Fugate-A/InterfaceWebAppSeniorDesign/Schematics/3D Files/AutoDesk/ChairBasePrototypePNG.png

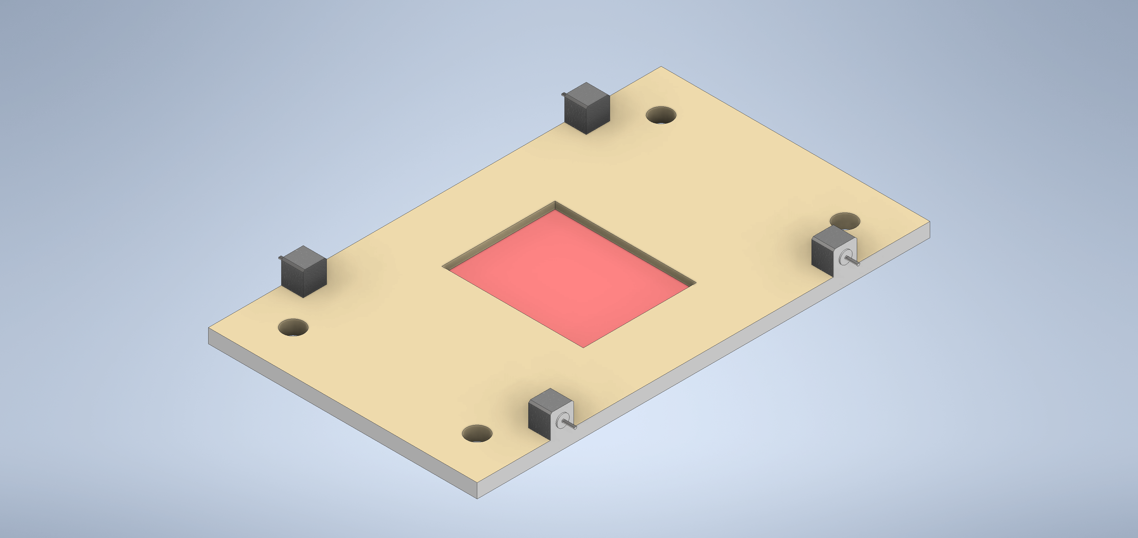
Schematics/3D Files/AutoDesk/ChairBasePrototypePNG.png
