Fugate-A/InterfaceWebAppSeniorDesign/WebAppPics/ChairGuruOverviewCommandSent.png

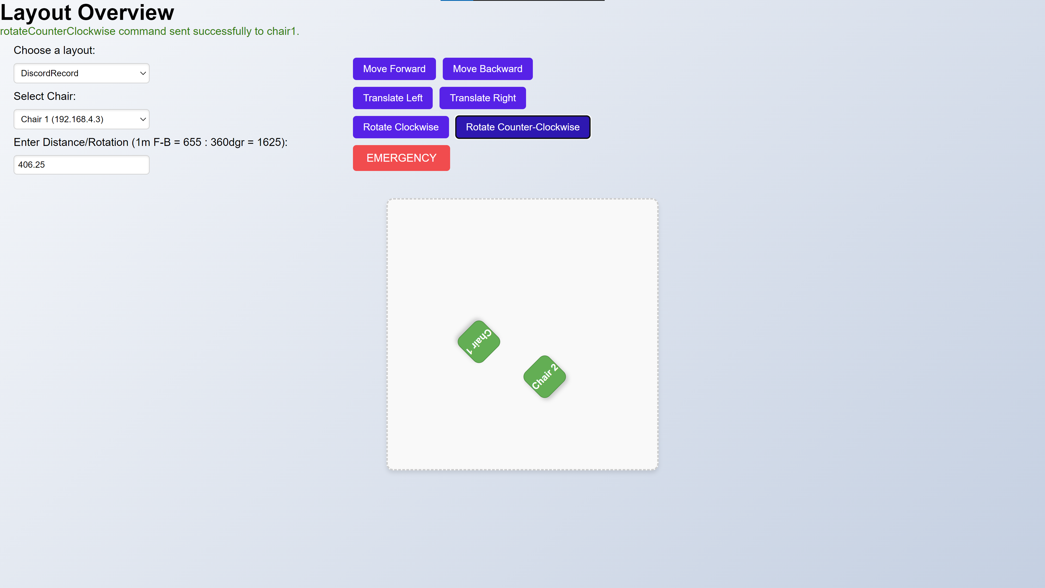
WebAppPics/ChairGuruOverviewCommandSent.png
