Fugate-A/InterfaceWebAppSeniorDesign/SoftwareDiagrams/ClassDiagramSD.png

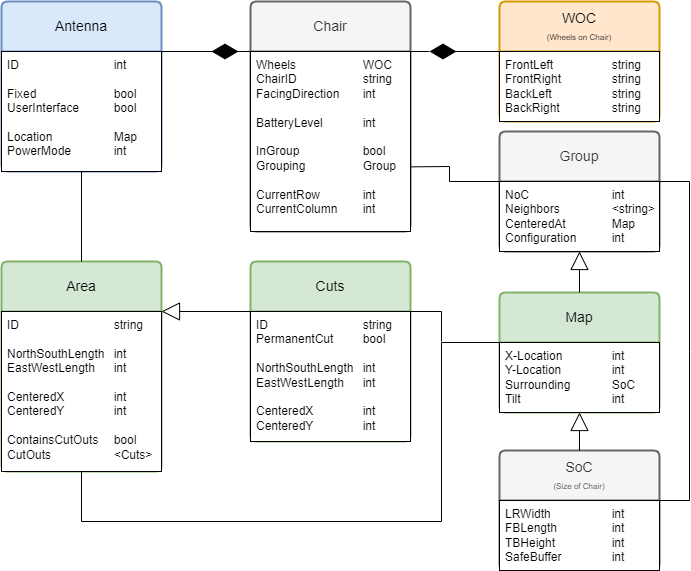
SoftwareDiagrams/ClassDiagramSD.png
