Fugate-A/InterfaceWebAppSeniorDesign/SoftwareDiagrams/CommunicationBlockDiagram.png

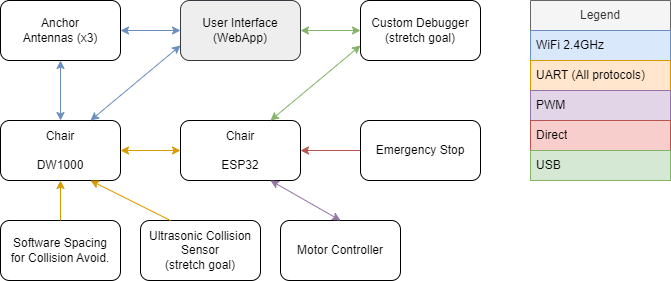
SoftwareDiagrams/CommunicationBlockDiagram.png
