Fugate-A/InterfaceWebAppSeniorDesign/SoftwareDiagrams/LocalVsServer.png

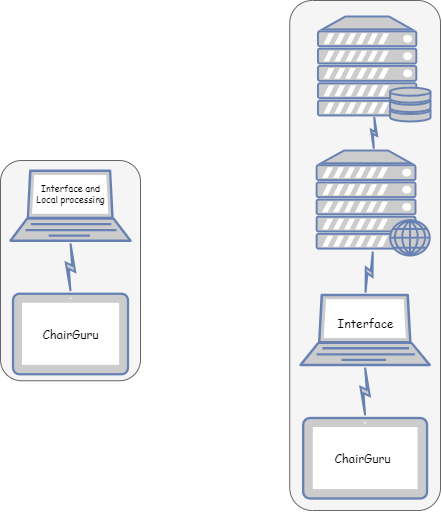
SoftwareDiagrams/LocalVsServer.png
