Fugate-A/InterfaceWebAppSeniorDesign/SoftwareDiagrams/MovementFlowchart.png

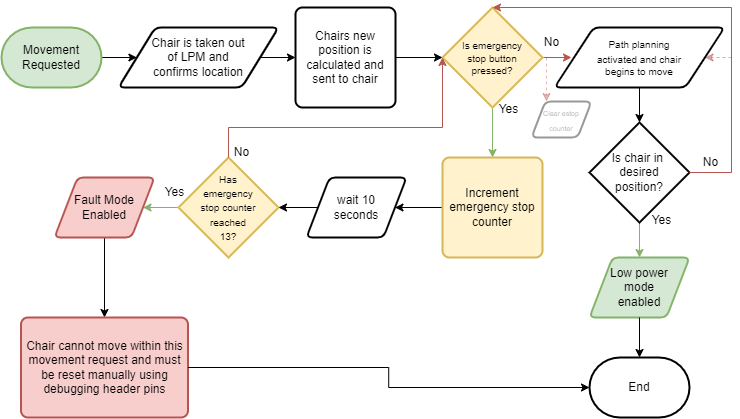
SoftwareDiagrams/MovementFlowchart.png
