Fugate-A/InterfaceWebAppSeniorDesign/WebAppPics/ChairGuruCreationLogged.png

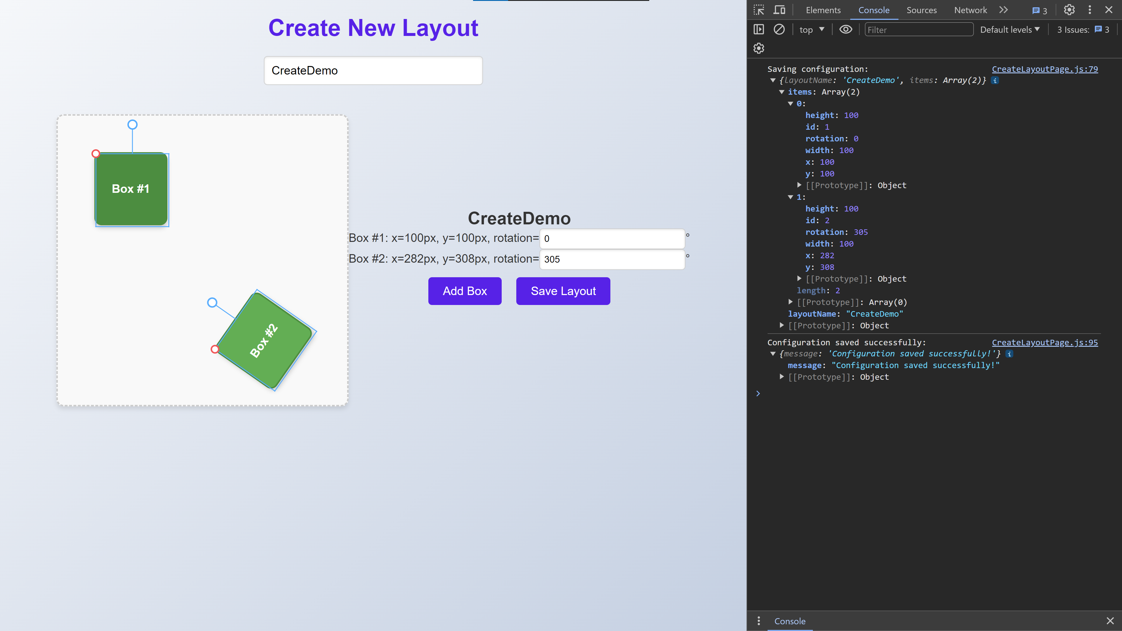
WebAppPics/ChairGuruCreationLogged.png
