Fugate-A/InterfaceWebAppSeniorDesign/WebAppPics/ChairGuruDanceModeOnHeaderLogged.png

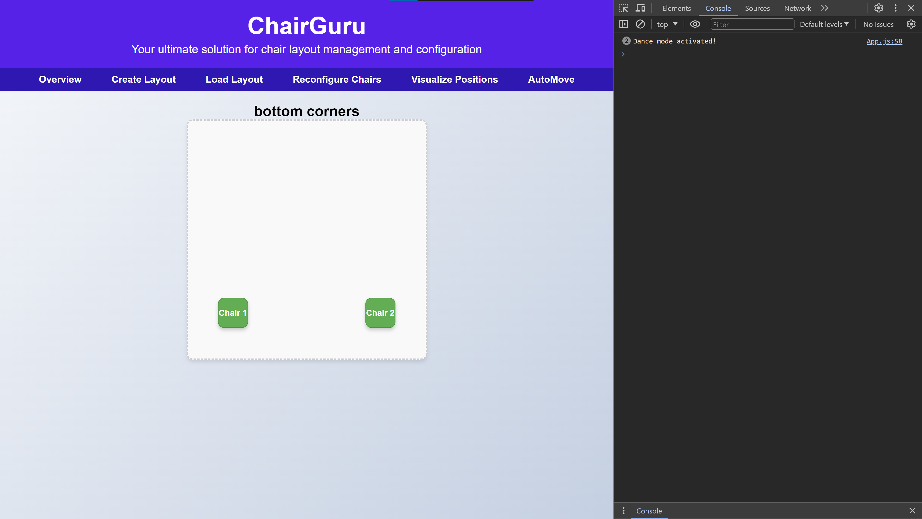
WebAppPics/ChairGuruDanceModeOnHeaderLogged.png
