Fugate-A/InterfaceWebAppSeniorDesign/WebAppPics/ChairGuruHome.png

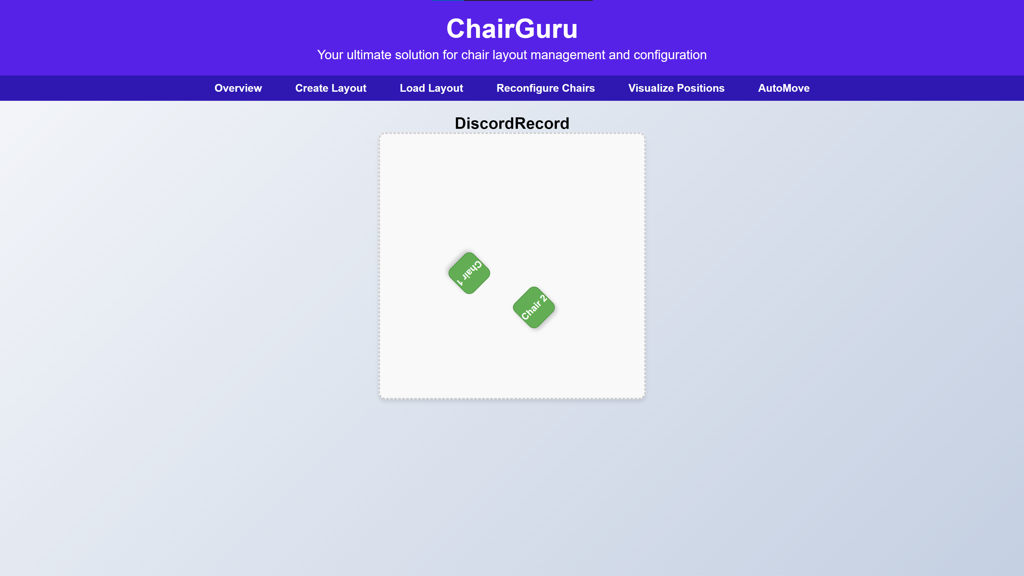
WebAppPics/ChairGuruHome.png
