Fugate-A/InterfaceWebAppSeniorDesign/WebAppPics/ChairGuruLayoutCreation.png

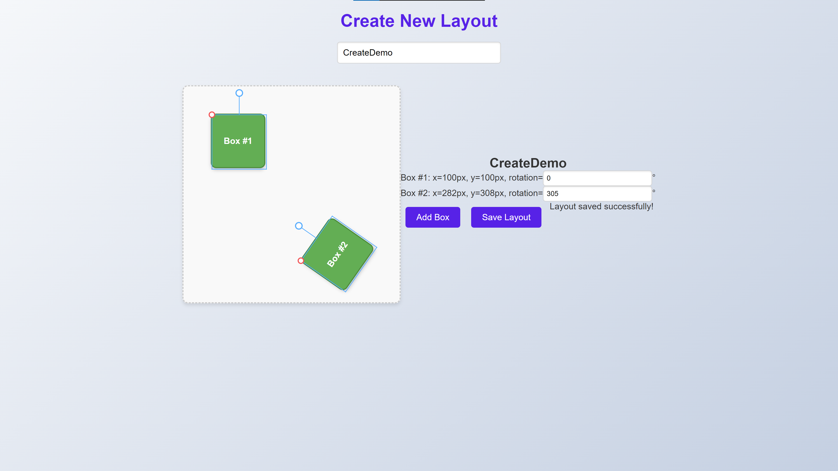
WebAppPics/ChairGuruLayoutCreation.png
