Fugate-A/InterfaceWebAppSeniorDesign/WebAppPics/ChairGuruLayoutsLoaded.png

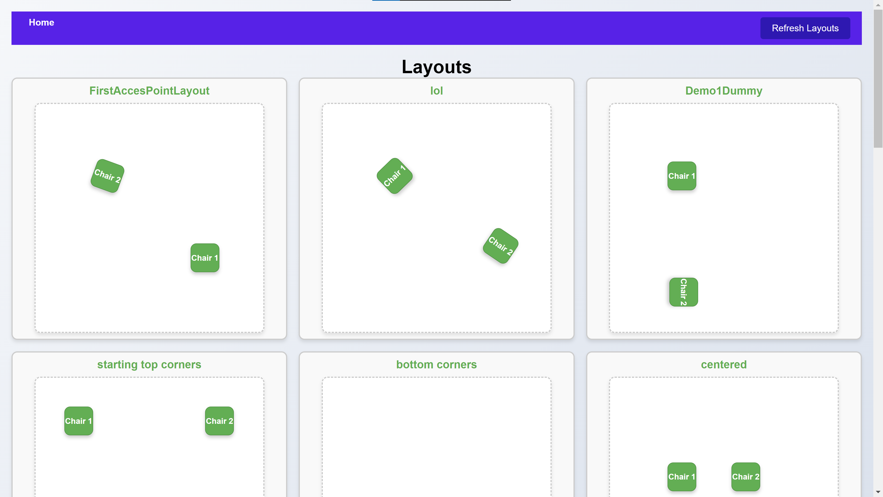
WebAppPics/ChairGuruLayoutsLoaded.png
