Fugate-A/InterfaceWebAppSeniorDesign/WebAppPics/ChairGuruPathPlanVisualizationWithLocation.png

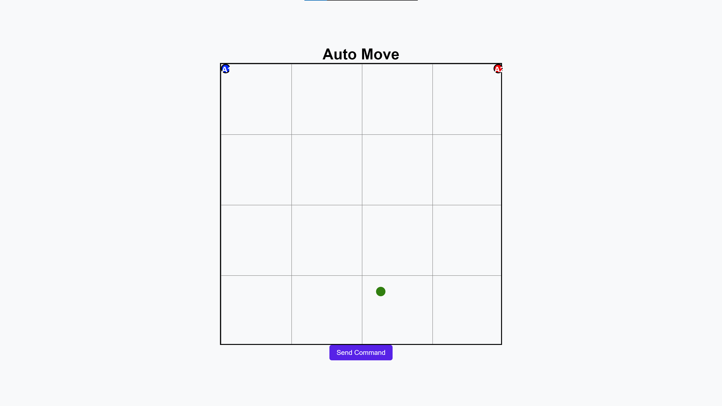
WebAppPics/ChairGuruPathPlanVisualizationWithLocation.png
