Fugate-A/InterfaceWebAppSeniorDesign/WebAppPics/ChairGuruReconfiguration.png

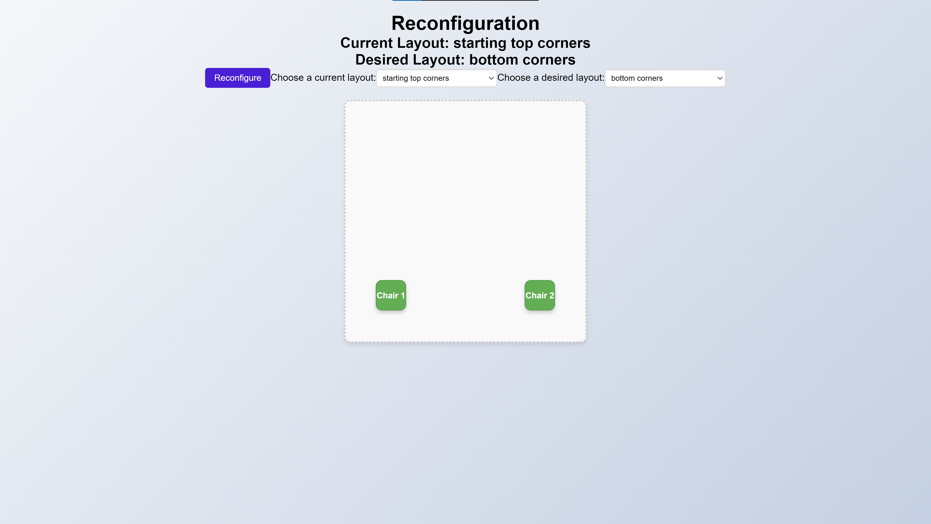
WebAppPics/ChairGuruReconfiguration.png
