Fugate-A/InterfaceWebAppSeniorDesign/WebAppPics/ChairGuruReconPathPlanningLogged.png

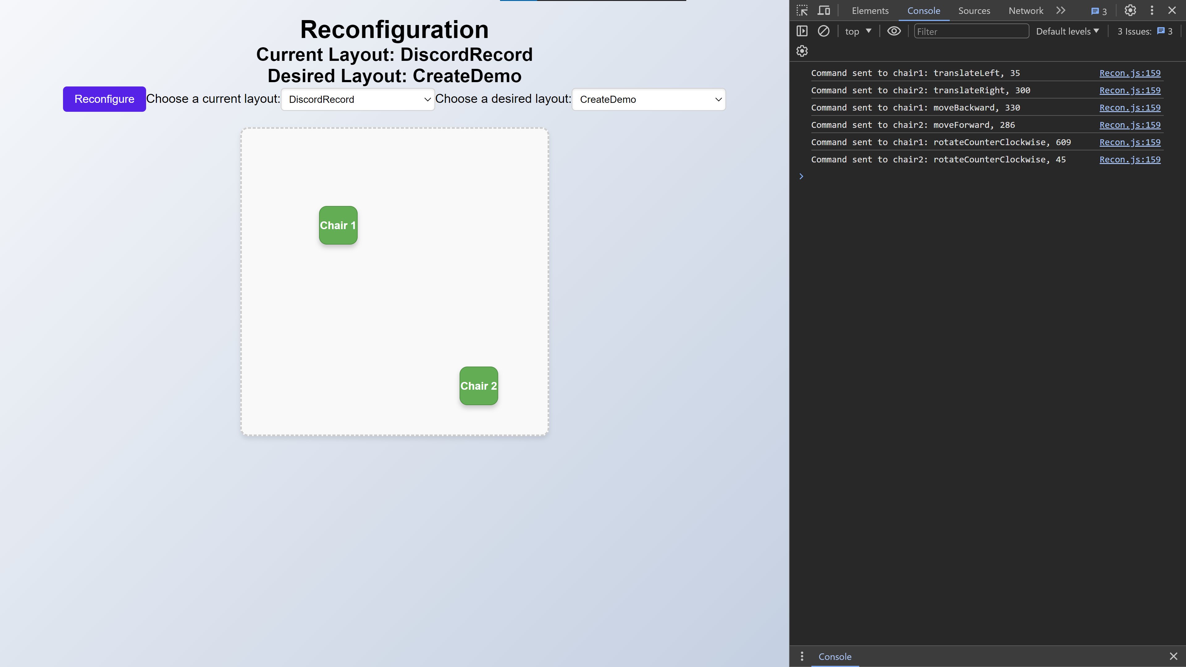
WebAppPics/ChairGuruReconPathPlanningLogged.png
