Fugate-A/InterfaceWebAppSeniorDesign/WebAppPics/ChairGuruVisualizeLocationWhenOn.png

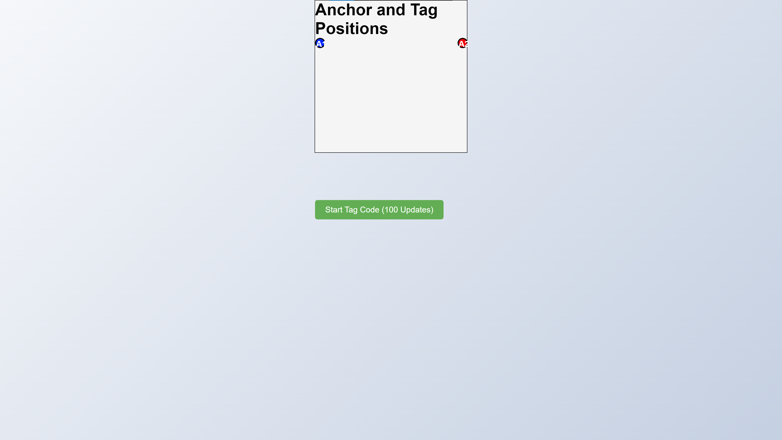
WebAppPics/ChairGuruVisualizeLocationWhenOn.png
