Fugate-A/InterfaceWebAppSeniorDesign/Schematics/UCF ECE SD G17 BOM.xlsx

Item # | Reference Designator | Quantity | Manufacturer | Part # | Description | Package | Purchase Website
1 | U1 | 1 | Espressif Systems | ESP-WROOM-32-N4 | RX TXRX MD BLUETOOTH WIFI SMD | 38-SMD Module | https://www.digikey.com/en/products/detail/espressif-systems/esp32-wroom-32-n4/8544298
2 | C6, C14, C15, C22 | 4 | YAGEO | CC0805KRX7R9BB104 | CAP CER 0.1UF 50V X7R 0805 | 0805 (2012 Metric) | https://www.digikey.com/en/products/detail/yageo/cc0805krx7r9bb104/302874
3 | R11, R21, R22, R23, R34, R15-1 | 6 | Panasonic | ERJ-6GEYJ103V | RES SMD 10K OHM 5% 1/8W 0805 | 0805 (2012 Metric) | https://www.digikey.com/en/products/detail/panasonic-electronic-components/erj-6geyj103v/83062
4 | S1, S2 | 2 | C&K | PTS647SN50SMTR2LFS | SWITCH TACTILE SPST-NO 0.05A 12V | 4.5mm x 4.5mm | https://www.digikey.com/en/products/detail/c-k/PTS-647-SN50-SMTR2-LFS/9649857
5 | C1, C3, C21, C31 | 4 | Taiyo Yuden | LMK212BJ226MG-T | CAP CER 22UF 10V X5R 0805 | 0805 (2012 Metric) | https://www.digikey.com/en/products/detail/taiyo-yuden/lmk212bj226mg-t/1646587
6 | Q1, Q2 | 2 | Comchip Technology | SS8050-G | TRANS NPN 25V 1.5A SOT23-3 | SOT-23-3 | https://www.digikey.com/en/products/detail/comchip-technology/ss8050-g/6138901
7 | R31, R32, R33 | 3 | YAGEO | RC0805FR-071KL | RES 1K OHM 1% 1/8W 0805 | 0805 (2012 Metric) | https://www.digikey.com/en/products/detail/yageo/RC0805FR-071KL/727444
8 | R25 | 1 | Stackpole Electronics Inc. | RMCF0805FT22K1 | RES 22.1K OHM 1% 1/8W 0805 | 0805 (2012 Metric) | https://www.digikey.com/en/products/detail/stackpole-electronics-inc/RMCF0805FT22K1/1760211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
9 | R26 | 1 | Stackpole Electronics Inc. | RMCF0805FT47K5 | RES 47.5K OHM 1% 1/8W 0805 | 0805 (2012 Metric) | https://www.digikey.com/en/products/detail/stackpole-electronics-inc/rmcf0805ft47k5/1760296
10 | J2 | 1 | CUI Devices | PJ-051AH | CONN PWR JACK 2X5.5MM SOLDER | 11.5 x 10.1 x 7.3mm | https://www.digikey.com/en/products/detail/cui-devices/pj-051ah/1644587
11 | U3 | 1 | Microchip Technology | AMS1117-3.3 | IC LDO REG 3.3V 1A SOT223 | SOT-223-3L | https://www.digikey.com/en/products/detail/microchip-technology/TC2117-3-3VDBTR/443726
12 | J3, J4 | 2 | Sullins Connector Solutions | PPTC191LFBN-RC | CONN HDR 19POS 0.1 TIN PCB | 2.54mm Through Hole | https://www.digikey.com/en/products/detail/sullins-connector-solutions/pptc191lfbn-rc/810157
13 | C19 | 1 | Vishay Vitramon | VJ0805Y104KXABE31 | CAP CER 0.1UF 50V X7R 0805 | 0805 (2012 Metric) | https://www.digikey.com/en/products/detail/vishay-vitramon/VJ0805Y104KXABE31/2972204
14 | IC3 | 1 | Silicon Labs | CP2102N-A02-GQFN28 | IC USB TO UART BRIDGE QFN28 | 28-WFQFN (5x5) | https://www.digikey.com/en/products/detail/silicon-labs/cp2102n-a02-gqfn28/9863477?_gl=1*rn39gg*_up*MQ..
15 | J1 | 1 | Amphenol ICC (FCI) | 87583-2010RLF | CONN RCPT USB2.0 TYPEA 4P SMD RA | 14 x 13.1 x 7.74mm | https://www.digikey.com/en/products/detail/amphenol-icc-fci/87583-2010rlf/5204002?_gl=1*1dbr0k4*_up*MQ..
16 | C20 | 1 | Murata Electronics | GRM219C80J475KE19D | CAP CER 4.7UF 6.3V X6S 0805 | 0805 (2012 Metric) | https://www.digikey.com/en/products/detail/murata-electronics/grm219c80j475ke19d/2546403
17 | R4, R5, R6, R7 | 4 | TE Connectivity Passive Product | CRGCQ0805J470R | RES 470 OHM 5% 1/8W 0805 | 0805 (2012 Metric) | https://www.digikey.com/en/products/detail/te-connectivity-passive-product/crgcq0805j470r/8576734
18 | D1, D2, D3, D4, LED1 | 5 | Broadcom Limited | HSMW-C170-U0000 | LED WHITE CHIP SMD | 0805 (2012 Metric) | https://www.digikey.com/en/products/detail/broadcom-limited/hsmw-c170-u0000/7325174
19 | R0-1 | 1 | Stackpole Electronics Inc. | RMCF0805ZT0R00 | RES 0 OHM JUMPER 1/8W 0805 | 0805 (2012 Metric) | https://www.digikey.com/en/products/detail/stackpole-electronics-inc/rmcf0805zt0r00/1756901
20 | U2 | 1 | Ai-Thinker | BU01 | RF TXRX MOD 802.15.4 PCB TH SMD | 24-SMD Module | https://www.digikey.com/en/products/detail/ai-thinker/BU01/16688861
21 | R2, R24 | 2 | YAGEO | RC0805JR-072KL | RES 2K OHM 5% 1/8W 0805 | 0805 (2012 Metric) | https://www.digikey.com/en/products/detail/yageo/rc0805jr-072kl/728268?_gl=1*1s04tn*_up*MQ..
22
23
24
25
26
27
28
29
30
31
32
33
34
35
The listed quantities are for ONE (1) board only. Multiply quantities by number of boards required.
