Fugate-A/InterfaceWebAppSeniorDesign/Schematics/V2 Components/file.png

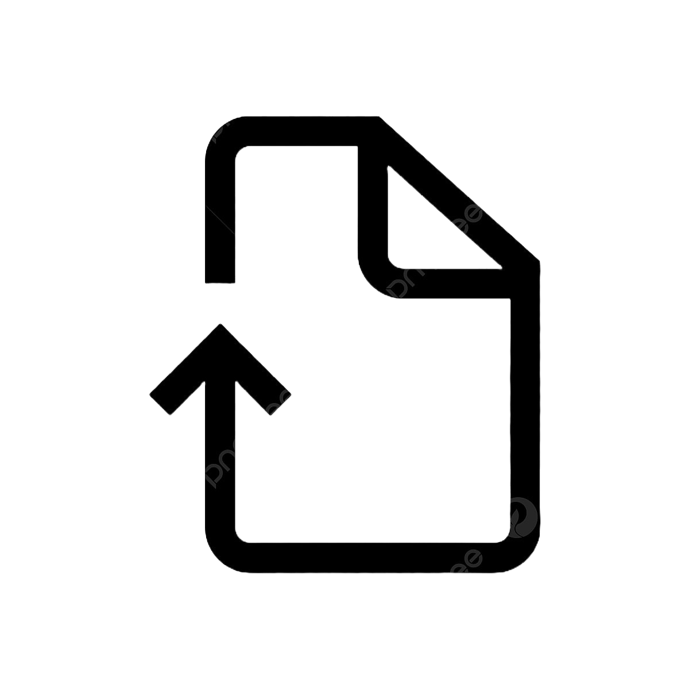
Schematics/V2 Components/file.png
