Fugate-A/InterfaceWebAppSeniorDesign/Schematics/V2 Components/LightningClipartPNG.png

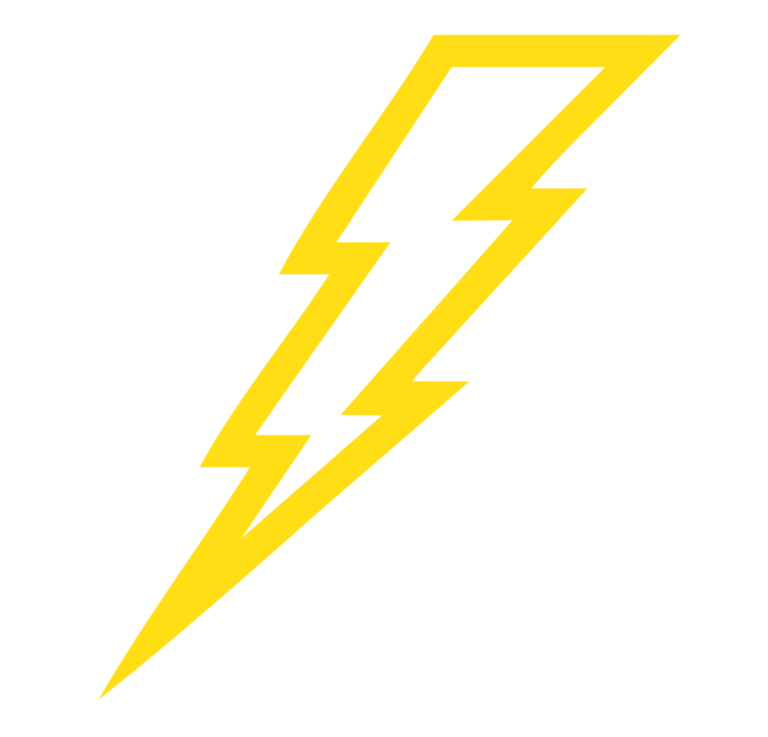
Schematics/V2 Components/LightningClipartPNG.png
