Fugate-A/InterfaceWebAppSeniorDesign/Schematics/3D Files/AutoDesk/Anchor Housing V2 (3).stl

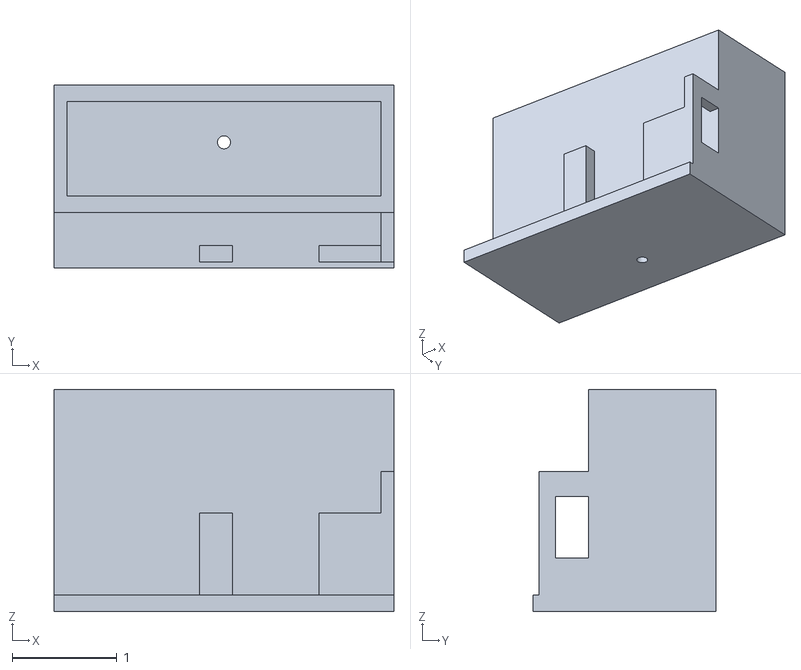
[picture p29: CAD file, 2024-11-13]
Schematics/3D Files/AutoDesk/Anchor Housing V2 (3).stl
3.25 x 1.75 x 2.13
