Fugate-A/InterfaceWebAppSeniorDesign/Schematics/3D Files/AutoDesk/SD/Borrow/Top Joystick PCB.stl

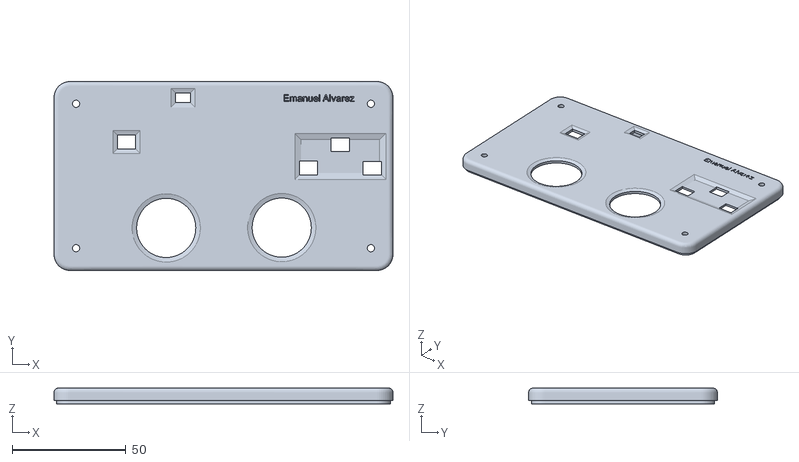
[picture p30: CAD file, 2024-11-25]
Schematics/3D Files/AutoDesk/SD/Borrow/Top Joystick PCB.stl
149.0 x 83.0 x 7.00
