Fugate-A/InterfaceWebAppSeniorDesign/Schematics/3D Files/AutoDesk/SD/BumperCustomPCB.stl

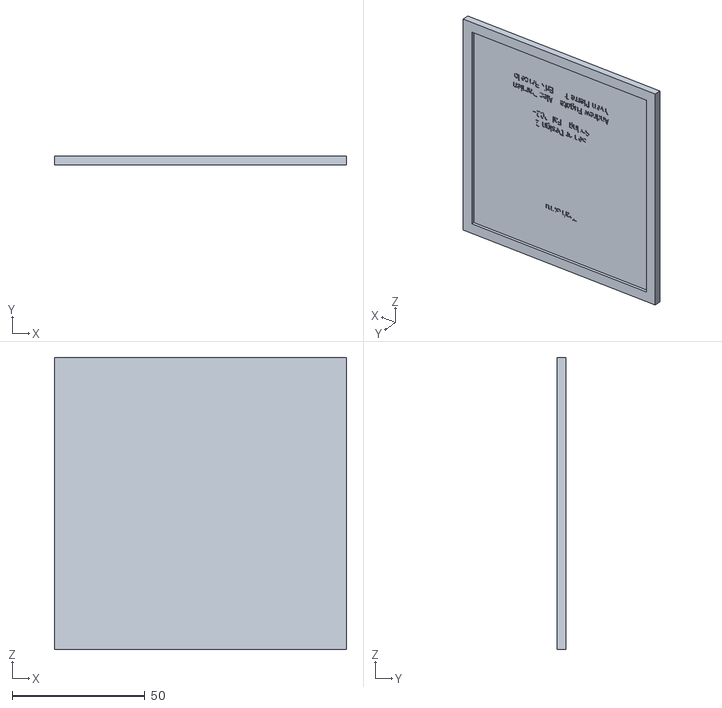
[picture p31: CAD file, 2024-11-25]
Schematics/3D Files/AutoDesk/SD/BumperCustomPCB.stl
110.0 x 3.50 x 110.0
