Fugate-A/InterfaceWebAppSeniorDesign/Schematics/3D Files/AutoDesk/SD/HousingPrint/InventorSaveOfSTL.stl

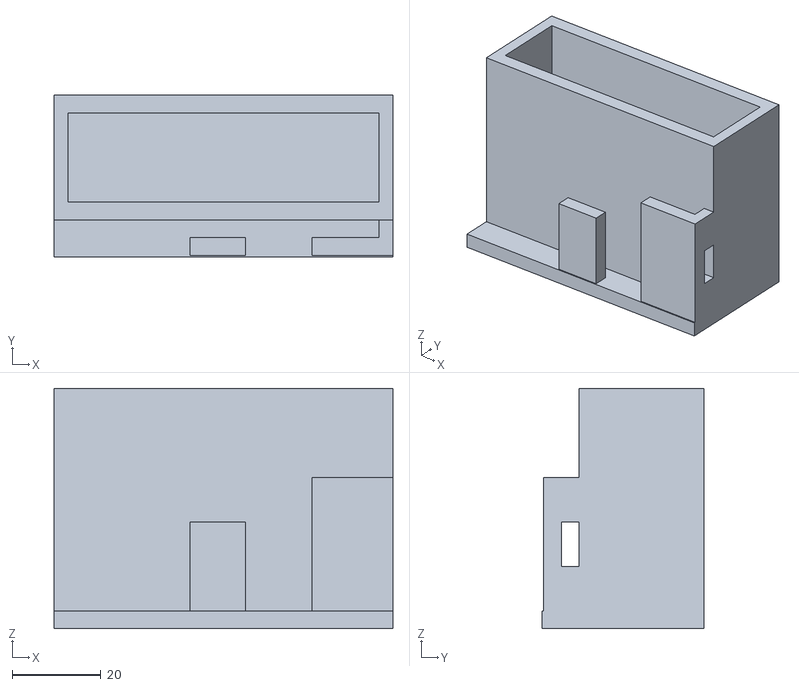
[picture p32: CAD file, 2024-11-25]
Schematics/3D Files/AutoDesk/SD/HousingPrint/InventorSaveOfSTL.stl
76.2 x 36.3 x 54.0
