Fugate-A/InterfaceWebAppSeniorDesign/Schematics/DRV8825 V1 Components/DRV8825PWPR/DRV8825PWPR.step

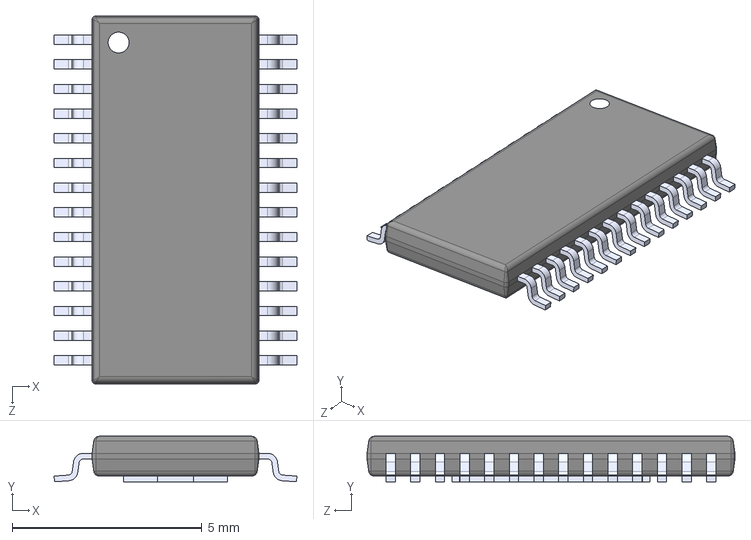
[picture p33: CAD file, 2024-11-13]
Schematics/DRV8825 V1 Components/DRV8825PWPR/DRV8825PWPR.step
6.40 x 1.20 x 9.70 mm
