Fugate-A/InterfaceWebAppSeniorDesign/Schematics/V2 Components/AMS1117-3.3/AMS1117-3.3.step

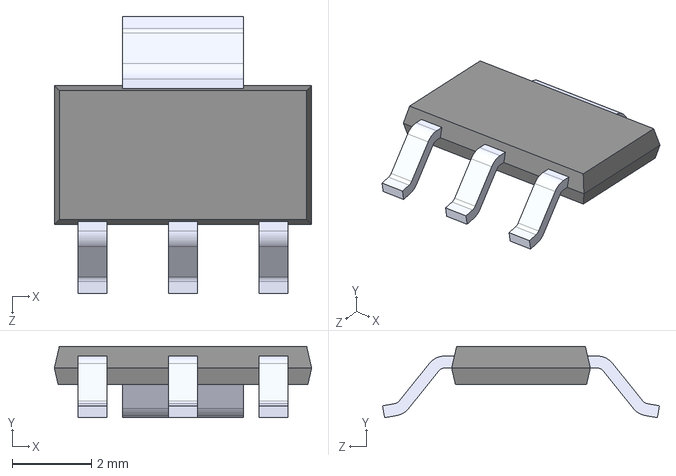
[picture p34: CAD file, 2024-10-04]
Schematics/V2 Components/AMS1117-3.3/AMS1117-3.3.step
6.50 x 1.80 x 7.00 mm
