Fugate-A/InterfaceWebAppSeniorDesign/Schematics/V2 Components/CP2102N-A02-GQFN28/3D/CP2102N-A02-GQFN28.stp

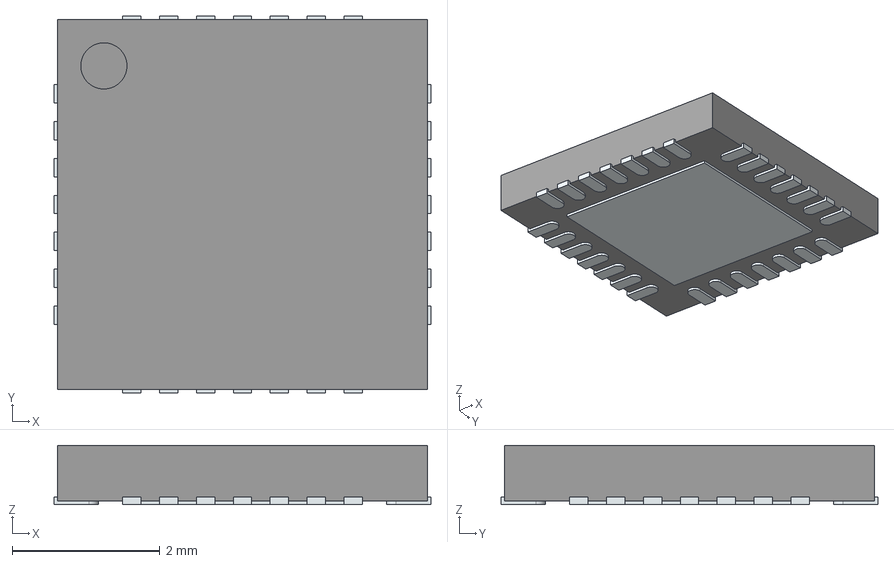
[picture p35: CAD file, 2024-09-06]
Schematics/V2 Components/CP2102N-A02-GQFN28/3D/CP2102N-A02-GQFN28.stp
5.10 x 5.10 x 0.8 mm
ThermalPin
PinsArrayLR
PinsArrayTB
