Fugate-A/InterfaceWebAppSeniorDesign/Schematics/V2 Components/CRGCQ0805J470R/CRGCQ0805J470R.step

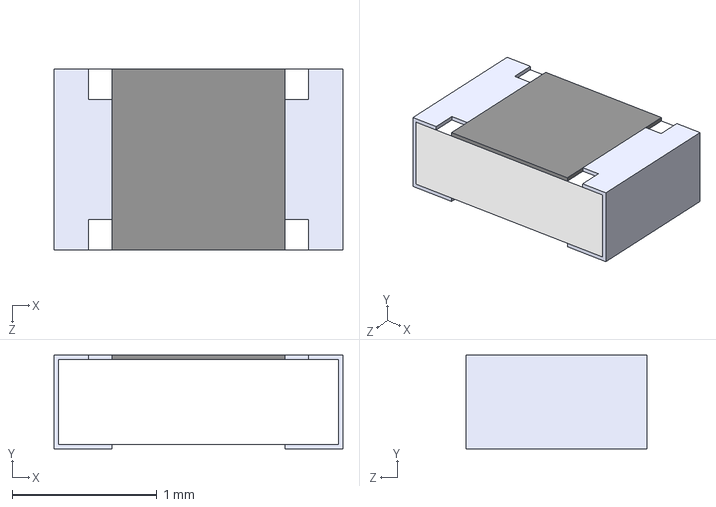
[picture p36: CAD file, 2024-09-06]
Schematics/V2 Components/CRGCQ0805J470R/CRGCQ0805J470R.step
2.00 x 0.65 x 1.25 mm
