Fugate-A/InterfaceWebAppSeniorDesign/Schematics/V2 Components/GRM219C80J475KE19D/3D/GRM219C80J475KE19D.stp

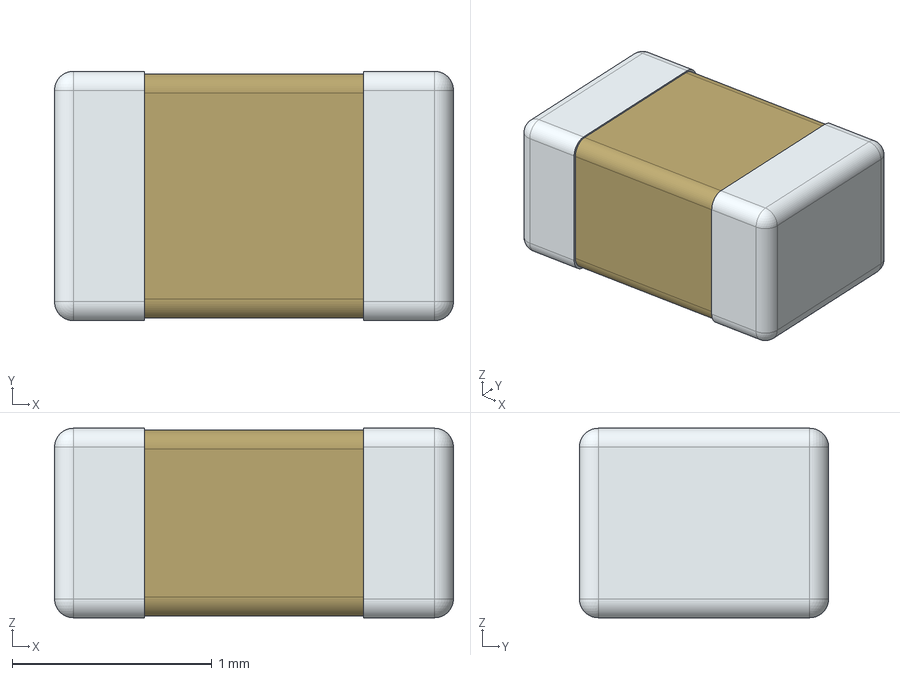
[picture p37: CAD file, 2024-09-06]
Schematics/V2 Components/GRM219C80J475KE19D/3D/GRM219C80J475KE19D.stp
2.00 x 1.25 x 0.95 mm
