Fugate-A/InterfaceWebAppSeniorDesign/Schematics/V2 Components/HSMW-C170-U0000/3D/HSMW-C170-U0000.stp

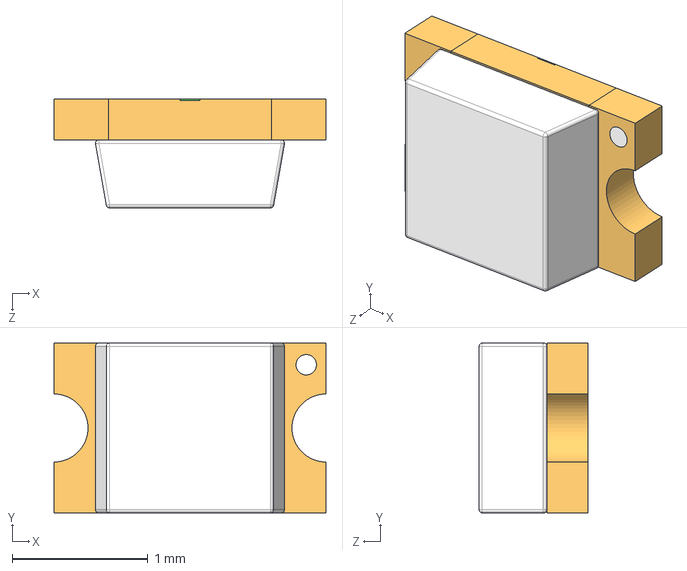
[picture p38: CAD file, 2024-10-04]
Schematics/V2 Components/HSMW-C170-U0000/3D/HSMW-C170-U0000.stp
2.00 x 1.25 x 0.8 mm
