Fugate-A/InterfaceWebAppSeniorDesign/Schematics/V2 Components/LIB_LMK212BBJ226MG-T/LMK212BBJ226MG-T/3D/LMK212BBJ226MG-T.stp

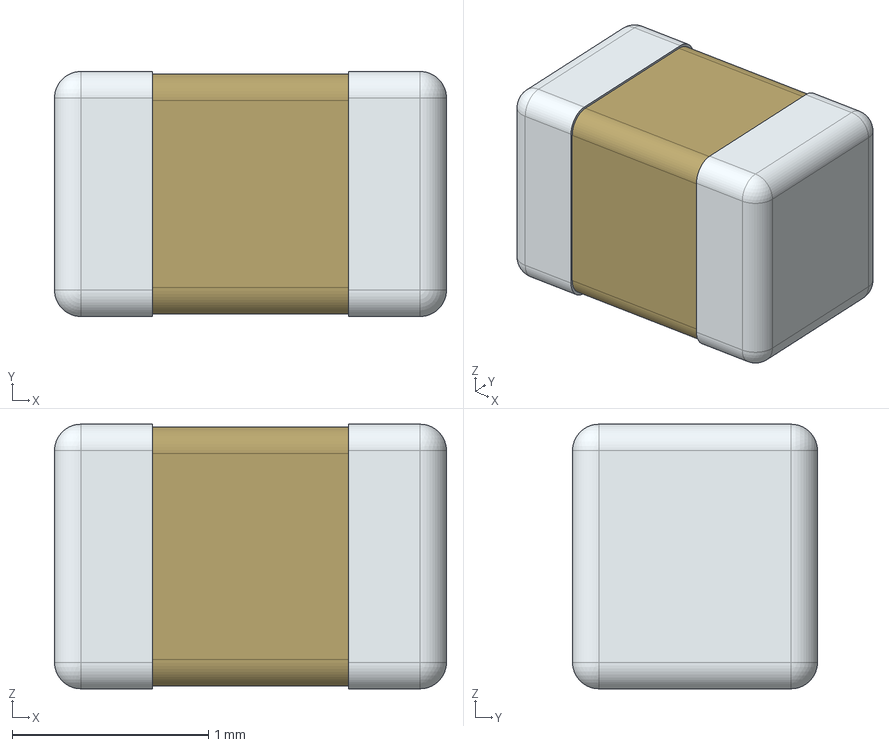
[picture p39: CAD file, 2024-10-04]
Schematics/V2 Components/LIB_LMK212BBJ226MG-T/LMK212BBJ226MG-T/3D/LMK212BBJ226MG-T.stp
2.00 x 1.25 x 1.35 mm
