Fugate-A/InterfaceWebAppSeniorDesign/Schematics/V2 Components/RC0805JR-072KL/RC0805JR-072KL.step

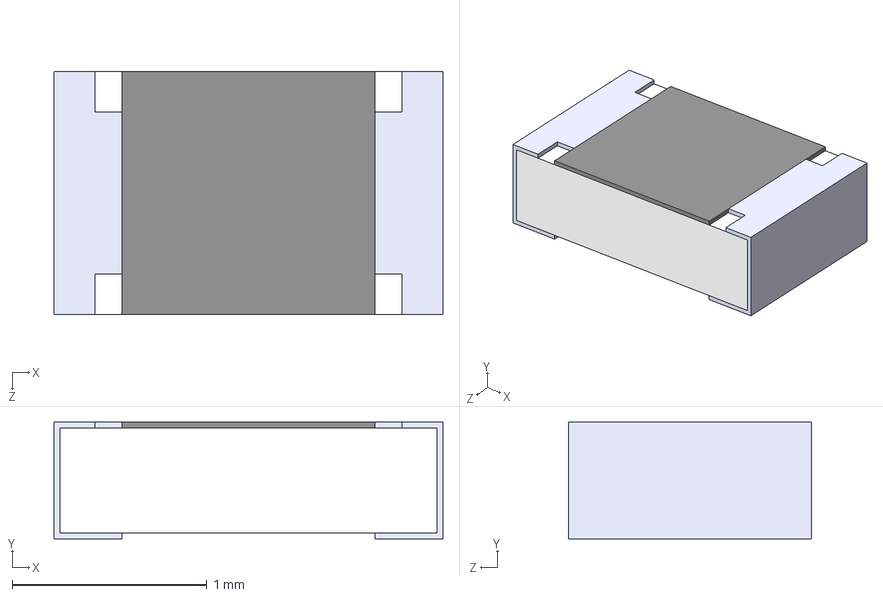
[picture p40: CAD file, 2024-10-04]
Schematics/V2 Components/RC0805JR-072KL/RC0805JR-072KL.step
2.00 x 0.6 x 1.25 mm
