Fugate-A/InterfaceWebAppSeniorDesign/Schematics/V2 Components/VJ0805Y104KXABE31/VJ0805Y104KXABE31.step

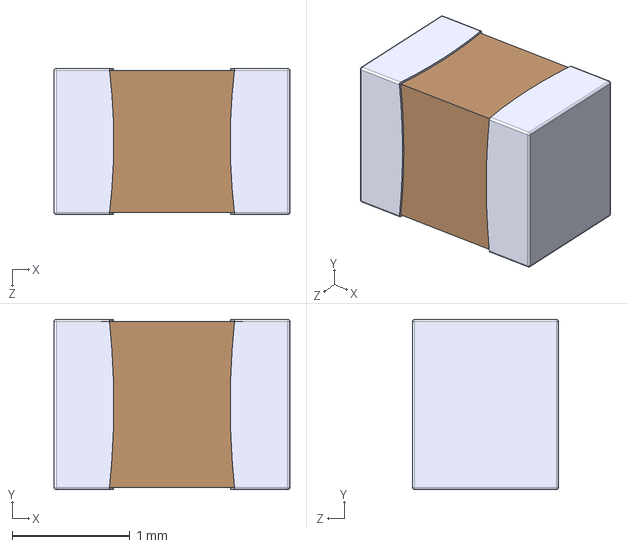
[picture p41: CAD file, 2024-10-04]
Schematics/V2 Components/VJ0805Y104KXABE31/VJ0805Y104KXABE31.step
2.01 x 1.45 x 1.24 mm
