Fugate-A/InterfaceWebAppSeniorDesign/Schematics/3D Files/AutoDesk/Anchor Housing V1.stl

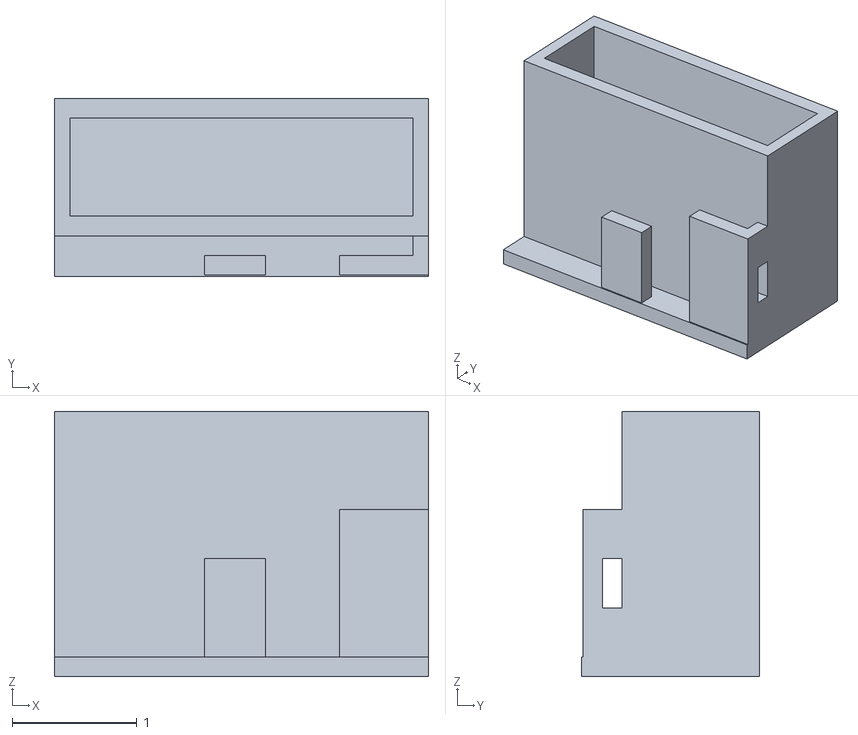
[picture p42: CAD file, 2024-11-13]
Schematics/3D Files/AutoDesk/Anchor Housing V1.stl
3.00 x 1.43 x 2.13
