Fugate-A/InterfaceWebAppSeniorDesign/Schematics/3D Files/AutoDesk/SD/HousingPrint/InventorSaveOfV2STL.stl

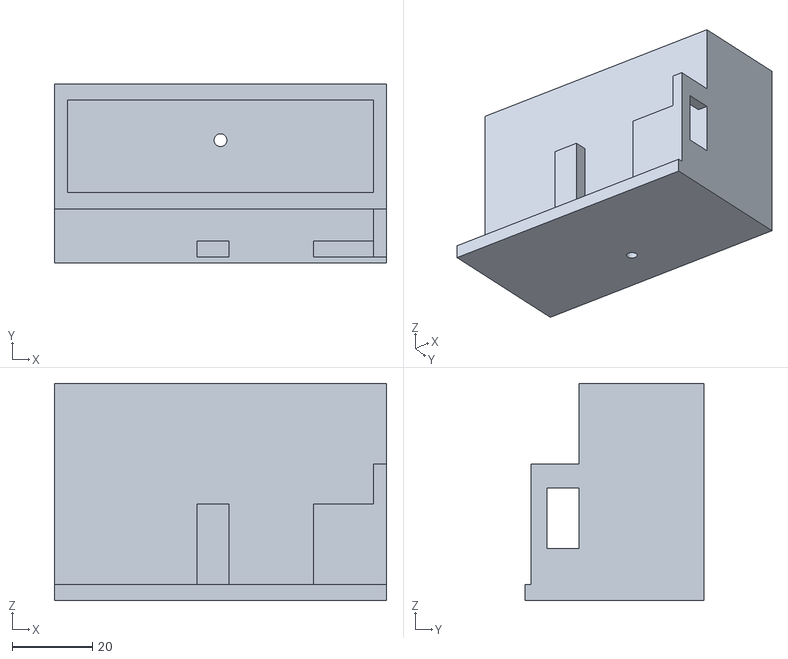
[picture p44: CAD file, 2024-11-25]
Schematics/3D Files/AutoDesk/SD/HousingPrint/InventorSaveOfV2STL.stl
82.5 x 44.5 x 54.0
