Fugate-A/InterfaceWebAppSeniorDesign/(list of files, cad)

Other CAD files:
Schematics/3D Files/AutoDesk/ChairBasePrototype.ipt
Schematics/3D Files/AutoDesk/SD/BumperCustomPCB.ipt
Schematics/V2 Components/87583-2010RLF/87583-2010RLF.step
Schematics/V2 Components/CP2102N-A02-GQFN28/Allegro/qfn50p500x500x80-29n-d.psm
Schematics/V2 Components/CP2102N-A02-GQFN28/DEHDL/cp2102n_a02_gqfn28/chips/chips.prt
Schematics/V2 Components/GRM219C80J475KE19D/Allegro/capc2012x95n.psm
Schematics/V2 Components/GRM219C80J475KE19D/DEHDL/grm219c80j475ke19d/chips/chips.prt
Schematics/V2 Components/HSMW-C170-U0000/Allegro/ledc2012x90n.psm
Schematics/V2 Components/HSMW-C170-U0000/DEHDL/hsmw_c170_u0000/chips/chips.prt
Schematics/V2 Components/LIB_LMK212BBJ226MG-T/LMK212BBJ226MG-T/Allegro/capc2012x135n.psm
Schematics/V2 Components/LIB_LMK212BBJ226MG-T/LMK212BBJ226MG-T/DEHDL/lmk212bbj226mg_t/chips/chips.prt
