Fugate-A/InterfaceWebAppSeniorDesign/(list of files, drawings)

Other design files:
Schematics/V2 Components/GRM219C80J475KE19D/Altium/CAPC2012X95N.PcbLib
Schematics/V2 Components/GRM219C80J475KE19D/Altium/GRM219C80J475KE19D.SchLib
Schematics/V2 Components/HSMW-C170-U0000/Altium/HSMW-C170-U0000.SchLib
Schematics/V2 Components/HSMW-C170-U0000/Altium/LEDC2012X90N.PcbLib
Schematics/V2 Components/LIB_LMK212BBJ226MG-T/LMK212BBJ226MG-T/Altium/CAPC2012X135N.PcbLib
Schematics/V2 Components/LIB_LMK212BBJ226MG-T/LMK212BBJ226MG-T/Altium/LMK212BBJ226MG-T.SchLib
