Fugate-A/InterfaceWebAppSeniorDesign/Schematics/G7 Senior Design V2/G7 Senior Design V2.kicad_pcb

## KiCad design Schematics/G7 Senior Design V2/G7 Senior Design V2.kicad_pcb (2024-11-13)

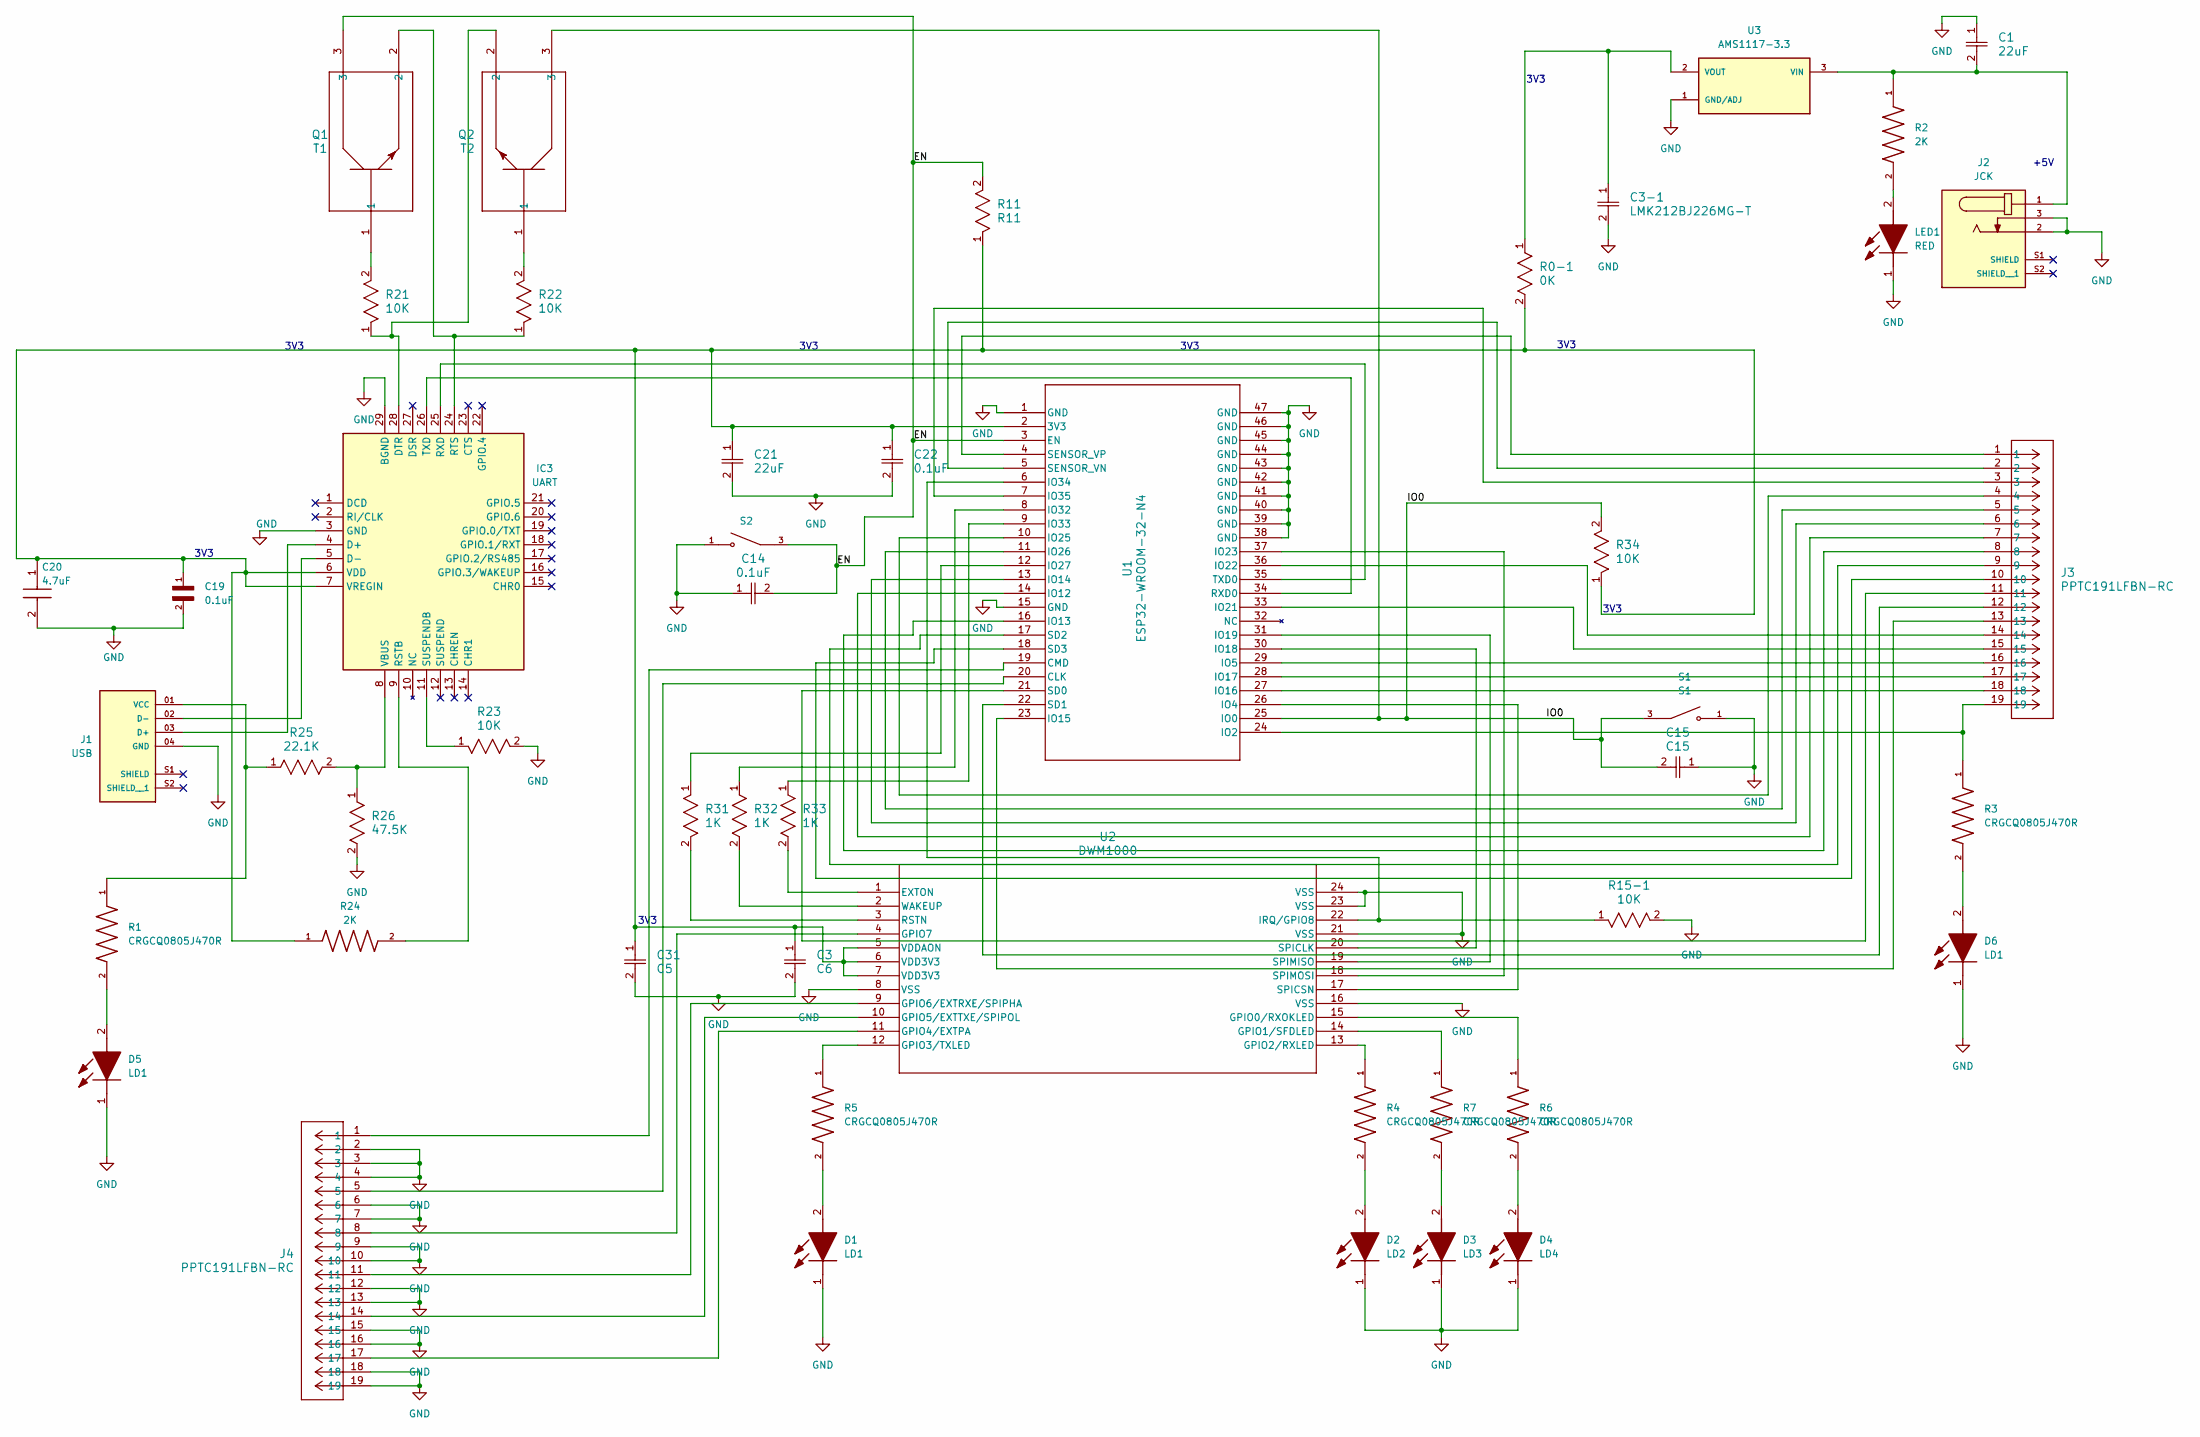
[picture p45: schematic G7 Senior Design V2.kicad_sch]

Parts:
C1, C21: 22uF; CAP_LMK212AB7106MG-T_TAY
C3: C6; CC0805N_YAG
C3-1: LMK212BJ226MG-T; CAP_LMK212AB7106MG-T_TAY
C14, C22: 0.1uF; CC0805N_YAG
C15: C15; CC0805N_YAG
C19: 0.1uF; CAPC2012X145N
C20: 4.7uF; CAPC2012X95N; Mouser Part Number 81-GRM219C80J475KE9D
C31: C5; CAP_LMK212AB7106MG-T_TAY
D1, D5, D6: LD1; LEDC2012X90N; Mouser Part Number 630-HSMW-C170-U0000
D2: LD2; LEDC2012X90N; Mouser Part Number 630-HSMW-C170-U0000
D3: LD3; LEDC2012X90N; Mouser Part Number 630-HSMW-C170-U0000
D4: LD4; LEDC2012X90N; Mouser Part Number 630-HSMW-C170-U0000
IC3: UART; QFN50P500X500X80-29N-D; Mouser Part Number 634-CP2102NA02GQFN28
J1: USB; AMPHENOL_87583-2010RLF; PARTREV AD
J2: JCK; CUI_PJ-051AH; PART_REV 1.0
J3, J4: PPTC191LFBN-RC; CONN19_PPTC191LFBN-RC_SUL
LED1: RED; LEDC2012X90N; Mouser Part Number 630-HSMW-C170-U0000
Q1: T1; TRAN_SS8050-G_CIP
Q2: T2; TRAN_SS8050-G_CIP
R0-1: 0K; STA_RMCF0805_STP
R1, R3, R4, R5, R6, R7: CRGCQ0805J470R; RESC2012X65N
R2, R24: 2K; RESC2012X60N
R11: R11; RC0805N_PAN
R15-1, R21, R22, R23, R34: 10K; RC0805N_PAN
R25: 22.1K; STA_RMCF0805_STP
R26: 47.5K; STA_RMCF080547.5K_STP
R31, R32, R33: 1K; RC0805N_YAG
S1: S1; SW_PTS_647_SN50_SMTR2_LFS; PARTREV 4 Apr 22
S2: S2; SW_PTS_647_SN50_SMTR2_LFS; PARTREV 4 Apr 22
U1: ESP32-WROOM-32-N4; MOD_ESP32-WROOM-32_EXP
U2: DWM1000; MOD_DWM1000_QOR
U3: AMS1117-3.3; SOT229P700X180-4N; PARTREV N/A

Connections:
/EN: C14.2, Q1.3, R11.2, S2.3, U1.3 (EN); also elsewhere on the board
/IO0: C15.2, Q2.3, R34.2, S1.3, U1.25 (IO0); also elsewhere on the board
GND: C1.1, C3.2, C3-1.2, C14.1, C15.1, C19.2, C20.2, C21.2, C22.2, C31.2, D1.1 (K), D2.1 (K), D3.1 (K), D4.1 (K), D5.1 (K), D6.1 (K), IC3.3 (GND), IC3.29 (BGND), J1.04 (GND), J2.2, J2.3, J4.2, J4.3, J4.4, J4.6, J4.7, J4.9, J4.10, J4.12, J4.13, J4.15, J4.16, J4.18, J4.19, LED1.1 (K), R15-1.2, R23.2, R26.2, S1.1, S2.1, U1.1 (GND), U1.15 (GND), U1.38 (GND), U1.39 (GND), U1.40 (GND), U1.41 (GND), U1.42 (GND), U1.43 (GND), U1.44 (GND), U1.45 (GND), U1.46 (GND), U1.47 (GND), U2.8 (VSS), U2.16 (VSS), U2.21 (VSS), U2.23 (VSS), U2.24 (VSS), U3.1 (GND/ADJ); also elsewhere on the board
unnamed: D1.2 (A), R5.2
unnamed: D2.2 (A), R4.2
unnamed: D3.2 (A), R7.2
unnamed: D4.2 (A), R6.2
unnamed: D5.2 (A), R1.2
unnamed: D6.2 (A), R3.2
unnamed: IC3.4 (D+), J1.03 (D+)
unnamed: IC3.5 (D-), J1.02 (D-)
unnamed: IC3.28 (DTR), Q2.2, R21.1
unnamed: IC3.9 (RSTB), R24.2
unnamed: IC3.24 (RTS), Q1.2, R22.1
unnamed: IC3.25 (RXD), U1.35 (TXD0)
unnamed: IC3.11 (SUSPENDB), R23.1
unnamed: IC3.26 (TXD), U1.34 (RXD0)
unnamed: IC3.8 (VBUS), R25.2, R26.1
unnamed: C3.1, C19.1, C20.1, C21.1, C22.1, C31.1, IC3.6 (VDD), IC3.7 (VREGIN), R0-1.2, R11.1, R24.1, R34.1, U1.2 (3V3), U2.5 (VDDAON), U2.6 (VDD3V3), U2.7 (VDD3V3)
unnamed: J1.01 (VCC), R1.1, R25.1
unnamed: LED1.2 (A), R2.2
unnamed: Q1.1, R21.2
unnamed: Q2.1, R22.2
unnamed: J4.5, U1.20 (CLK)
unnamed: J4.1, U1.19 (CMD)
unnamed: J3.19, R3.1, U1.24 (IO2)
unnamed: U1.26 (IO4), U2.17 (SPICSN)
unnamed: J3.16, U1.29 (IO5)
unnamed: J3.7, U1.14 (IO12)
unnamed: J3.8, U1.16 (IO13)
unnamed: J3.6, U1.13 (IO14)
unnamed: J3.13, U1.23 (IO15)
unnamed: J3.18, U1.27 (IO16)
unnamed: J3.17, U1.28 (IO17)
unnamed: U1.30 (IO18), U2.20 (SPICLK)
unnamed: U1.31 (IO19), U2.19 (SPIMISO)
unnamed: J3.15, U1.33 (IO21)
unnamed: J3.14, U1.36 (IO22)
unnamed: U1.37 (IO23), U2.18 (SPIMOSI)
unnamed: J3.4, U1.10 (IO25)
unnamed: J3.5, U1.11 (IO26)
unnamed: R31.1, U1.12 (IO27)
unnamed: R32.1, U1.8 (IO32)
unnamed: R33.1, U1.9 (IO33)
unnamed: R15-1.1, U1.6 (IO34), U2.22 (IRQ/GPIO8)
unnamed: J3.3, U1.7 (IO35)
unnamed: J3.11, U1.21 (SD0)
unnamed: J3.12, U1.22 (SD1)
unnamed: J3.9, U1.17 (SD2)
unnamed: J3.10, U1.18 (SD3)
unnamed: J3.2, U1.5 (SENSOR_VN)
unnamed: J3.1, U1.4 (SENSOR_VP)
unnamed: R33.2, U2.1 (EXTON)
unnamed: R6.1, U2.15 (GPIO0/RXOKLED)
unnamed: R7.1, U2.14 (GPIO1/SFDLED)
unnamed: R4.1, U2.13 (GPIO2/RXLED)
unnamed: R5.1, U2.12 (GPIO3/TXLED)
unnamed: J4.17, U2.11 (GPIO4/EXTPA)
unnamed: J4.14, U2.10 (GPIO5/EXTTXE/SPIPOL)
unnamed: J4.11, U2.9 (GPIO6/EXTRXE/SPIPHA)
unnamed: J4.8, U2.4 (GPIO7)
unnamed: R31.2, U2.3 (RSTN)
unnamed: R32.2, U2.2 (WAKEUP)
unnamed: C1.2, J2.1, R2.1, U3.3 (VIN)
unnamed: C3-1.1, R0-1.1, U3.2 (VOUT)

Notes on the sheet:
3V3
+5V

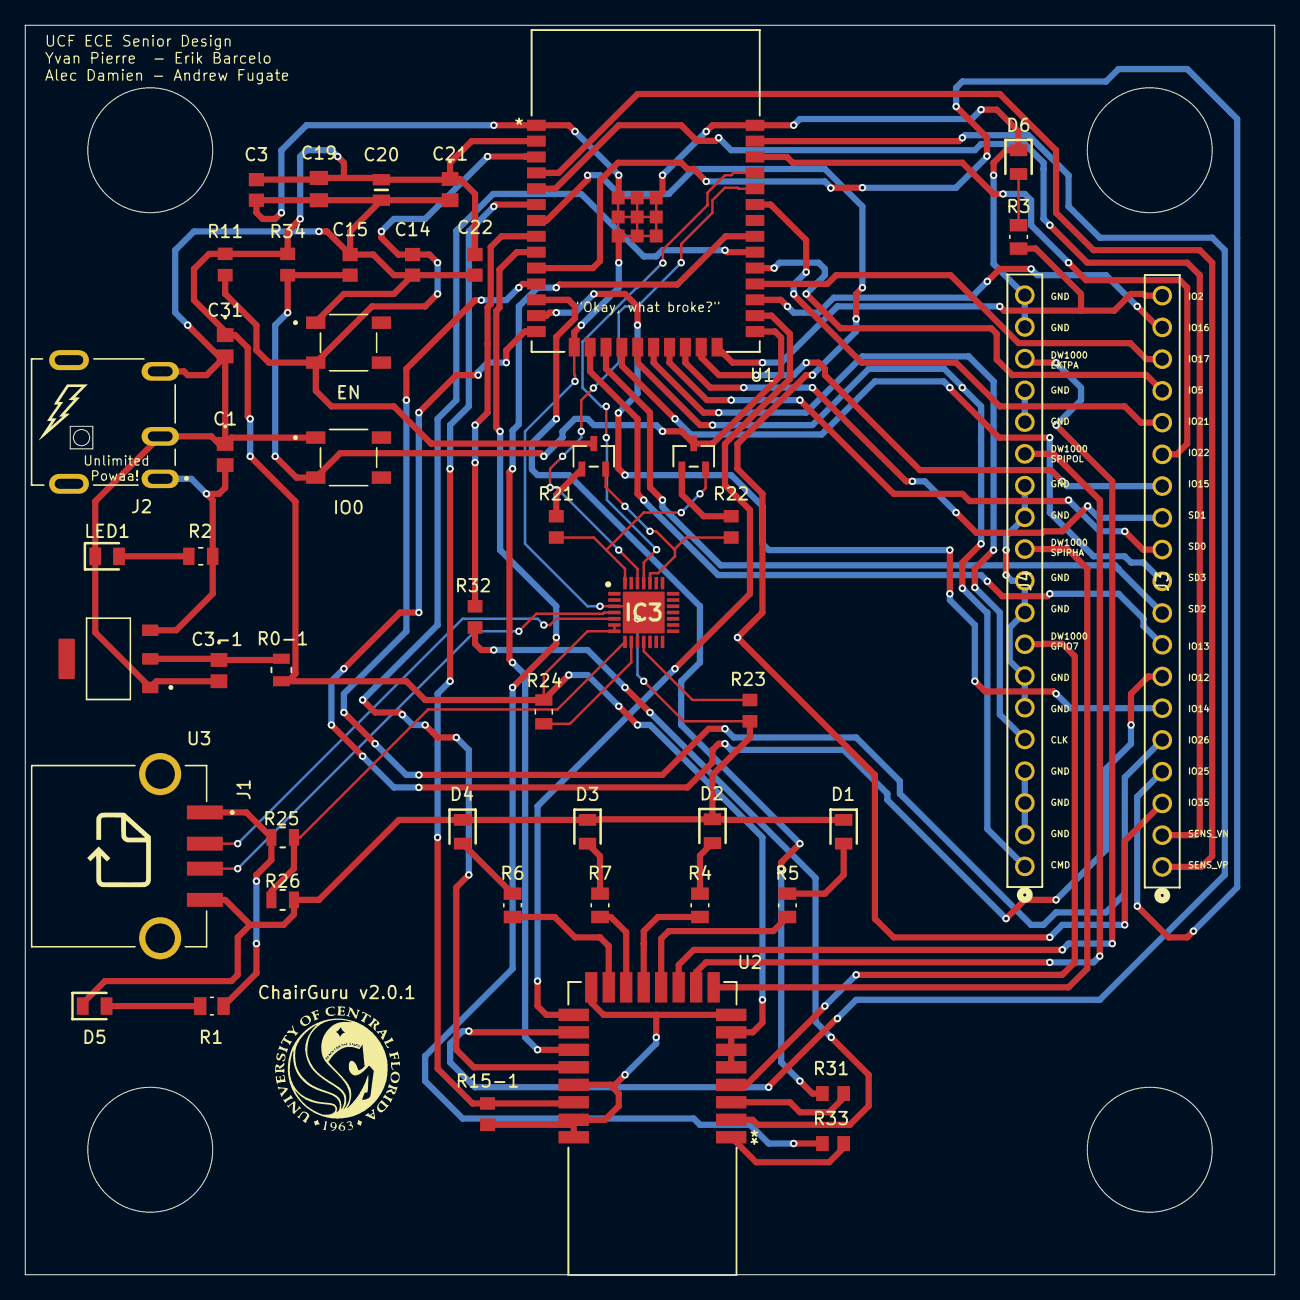
[picture p46: board G7 Senior Design V2.kicad_pcb from above]

Board: 2 copper layers, 100.0 x 100.0 mm, 49 parts (0 on the bottom side), 65 nets.

Other parts of the board:
EN: S2; SW_PTS_647_SN50_SMTR2_LFS
IO0: S1; SW_PTS_647_SN50_SMTR2_LFS

Their connections:
/EN: EN.3; also elsewhere on the board
/IO0: IO0.3; also elsewhere on the board
GND: EN.1, IO0.1; also elsewhere on the board
