Fugate-A/InterfaceWebAppSeniorDesign/Combo2/Combo2/TB6600_Code.cpp

#include <WiFi.h>
#include <WebServer.h>
#include <ArduinoJson.h>
#include "TB6600_Code.h"

// Define motor pins
//front left
const int PULFL = 25;
const int DIRFL = 26;
const int ENAFL = 15;

//rear left
const int PULRL = 18;
const int DIRRL = 19;
const int ENARL = 15;

//front right
const int PULFR = 13;
const int DIRFR = 14;
const int ENAFR = 15;

//rear right
const int PULRR = 2;
const int DIRRR = 12;
const int ENARR = 15;

//1 step = 0.001525 Meters
//655 steps per meter.

void moveForward(int steps) {
  Serial.print("Moving forward for ");
  Serial.print(steps);
  Serial.println(" steps");

  digitalWrite(DIRFL, LOW);
  digitalWrite(DIRRL, LOW);
  digitalWrite(DIRFR, HIGH);
  digitalWrite(DIRRR, HIGH);


  // Constant speed phase
    for (int i = 0; i < steps; i++) {
      digitalWrite(PULFL, HIGH);
      digitalWrite(PULFR, HIGH);
      digitalWrite(PULRL, HIGH);
      digitalWrite(PULRR, HIGH);
      delayMicroseconds(20);  // Normal delay for full speed
      digitalWrite(PULFL, LOW);
      digitalWrite(PULFR, LOW);
      digitalWrite(PULRL, LOW);
      digitalWrite(PULRR, LOW);
      delayMicroseconds(8000);
    }

  delay(1500);
}

void moveBackward(int steps) {
  Serial.print("Moving backward for ");
  Serial.print(steps);
  Serial.println(" steps");

  digitalWrite(DIRFL, HIGH);
  digitalWrite(DIRRL, HIGH);
  digitalWrite(DIRFR, LOW);
  digitalWrite(DIRRR, LOW);

  for (int i = 0; i < steps; i++) {
      digitalWrite(PULFL, HIGH);
      digitalWrite(PULFR, HIGH);
      digitalWrite(PULRL, HIGH);
      digitalWrite(PULRR, HIGH);
      delayMicroseconds(20);  // Normal delay for full speed
      digitalWrite(PULFL, LOW);
      digitalWrite(PULFR, LOW);
      digitalWrite(PULRL, LOW);
      digitalWrite(PULRR, LOW);
      delayMicroseconds(8000);
    }

  delay(1500);
}

void translateRight(int steps) {
  
  Serial.print("Translating right for ");
  Serial.print(steps);
  Serial.println(" steps");

  digitalWrite(DIRFL, LOW);
  digitalWrite(DIRRL, HIGH);
  digitalWrite(DIRFR, LOW);
  digitalWrite(DIRRR, HIGH);

  for (int i = 0; i < steps; i++) {
       digitalWrite(PULFL, HIGH);
      digitalWrite(PULFR, HIGH);
      digitalWrite(PULRL, HIGH);
      digitalWrite(PULRR, HIGH);
      delayMicroseconds(20);  // Normal delay for full speed
      digitalWrite(PULFL, LOW);
      digitalWrite(PULFR, LOW);
      digitalWrite(PULRL, LOW);
      digitalWrite(PULRR, LOW);
      delayMicroseconds(9000);
    }
  

  delay(1500);
}

void translateLeft(int steps) {
  
  Serial.print("Translating left for ");
  Serial.print(steps);
  Serial.println(" steps");

  digitalWrite(DIRFL, HIGH);
  digitalWrite(DIRRL, LOW);
  digitalWrite(DIRFR, HIGH);
  digitalWrite(DIRRR, LOW);
    // Constant speed phase
    for (int i = 0; i < steps; i++) {
       digitalWrite(PULFL, HIGH);
      digitalWrite(PULFR, HIGH);
      digitalWrite(PULRL, HIGH);
      digitalWrite(PULRR, HIGH);
      delayMicroseconds(20);  // Normal delay for full speed
      digitalWrite(PULFL, LOW);
      digitalWrite(PULFR, LOW);
      digitalWrite(PULRL, LOW);
      digitalWrite(PULRR, LOW);
      delayMicroseconds(9000);
    }

  delay(1500);
}

void rotateClockwise(int steps) {
  Serial.print("Rotating clockwise for ");
  Serial.print(steps);
  Serial.println(" steps");

  digitalWrite(DIRFL, LOW);
  digitalWrite(DIRRL, LOW);
  digitalWrite(DIRFR, LOW);
  digitalWrite(DIRRR, LOW);

  for (int i = 0; i < steps; i++) {
     digitalWrite(PULFL, HIGH);
      digitalWrite(PULFR, HIGH);
      digitalWrite(PULRL, HIGH);
      digitalWrite(PULRR, HIGH);
      delayMicroseconds(20);  // Normal delay for full speed
      digitalWrite(PULFL, LOW);
      digitalWrite(PULFR, LOW);
      digitalWrite(PULRL, LOW);
      digitalWrite(PULRR, LOW);
    delayMicroseconds(9000);
  }

  delay(1500);
}

void rotateCounterClockwise(int steps) {
  Serial.print("Rotating counter-clockwise for ");
  Serial.print(steps);
  Serial.println(" steps");

  digitalWrite(DIRFL, HIGH);
  digitalWrite(DIRRL, HIGH);
  digitalWrite(DIRFR, HIGH);
  digitalWrite(DIRRR, HIGH);

  for (int i = 0; i < steps; i++) {
     digitalWrite(PULFL, HIGH);
      digitalWrite(PULFR, HIGH);
      digitalWrite(PULRL, HIGH);
      digitalWrite(PULRR, HIGH);
      delayMicroseconds(20);  // Normal delay for full speed
      digitalWrite(PULFL, LOW);
      digitalWrite(PULFR, LOW);
      digitalWrite(PULRL, LOW);
      digitalWrite(PULRR, LOW);
    delayMicroseconds(9000);
  }


  delay(1500);
}


// In motor.cpp
void setupMotor() {
  // Your motor initialization code here
  pinMode(PULFL, OUTPUT);
  pinMode(DIRFL, OUTPUT);
  pinMode(ENAFL, OUTPUT);
  pinMode(PULRL, OUTPUT);
  pinMode(DIRRL, OUTPUT);
  pinMode(ENARL, OUTPUT);
  pinMode(PULFR, OUTPUT);
  pinMode(DIRFR, OUTPUT);
  pinMode(ENAFR, OUTPUT);
  pinMode(PULRR, OUTPUT);
  pinMode(DIRRR, OUTPUT);
  pinMode(ENARR, OUTPUT);

  Serial.println("Motor setup complete");
}
