Fugate-A/InterfaceWebAppSeniorDesign/(commit log)

2024-09-06 adding folder for eric to add schematic of PCB
2024-09-06 not working but committing before losing lol
    [87583-2010RLF.step, CAPC2012X145N.PcbLib, CAPC2012X95N.PcbLib, CP2102N-A02-GQFN28.stp, CRGCQ0805F180K.step, EDI2CAP.CFG, G7 Senior Design V2.kicad_pcb, G7 Senior Design V2.kicad_sch]
2024-09-06 adding text box
    just to learn Git, we put a text box!!!!!!!!!!!!!!
    [G7 Senior Design V2.kicad_sch]
2024-09-09 Added Changes from Last Meeting
    [EDI2CAP.CFG, G7 Senior Design V2.kicad_pcb, G7 Senior Design V2.kicad_sch, HSMW-C170-U0000.SchLib, HSMW-C170-U0000.stp, LEDC2012X90N.PcbLib, chips.prt, ledc2012x90n.psm]
2024-09-09 random kicad stuff
2024-09-09 Weeks Revision before Jungle of Words
    [G7 Senior Design V2.kicad_pcb]
2024-09-09 labels adjusted
    [G7 Senior Design V2.kicad_pcb]
2024-09-12 First Version to be Ordered from JLCPCB
    Associated schematic with first Gerber file to be sent out to JLCPCB to be fabricated.
    [87583-2010RLF.step, AMS1117-3.3.step, CAPC2012X135N.PcbLib, CRGCQ0805J470R.step, EDI2CAP.CFG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]
2024-09-12 One Page Error Report Gerber
    [G7 Senior Design V2-B_Cu.gbl, G7 Senior Design V2-B_Mask.gbs, G7 Senior Design V2-B_Paste.gbp, G7 Senior Design V2-B_Silkscreen.gbo, G7 Senior Design V2-Edge_Cuts.gm1, G7 Senior Design V2-F_Cu.gtl, G7 Senior Design V2-F_Mask.gts, G7 Senior Design V2-F_Paste.gtp]
2024-09-12 Initial BOM added
    [BOM.csv]
2024-09-13 Updated Gerber and BOM 13 SEP 24
    [BOM.csv, CAPC2012X145N.PcbLib, EDI2CAP.CFG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]
2024-10-03 commit arduino stuff forgetting schematic changes
2024-10-06 ChairGuru V1.1
    Updated Changes According to Doc as of 06 OCT 24.
    [G7 Senior Design V2.kicad_pcb, G7 Senior Design V2.kicad_sch]
2024-10-07 current in lab model
2024-10-07 ChairGuru 7 OCT 24 NIGHT
    Andrew's Updated Content
    [G7 Senior Design V2.kicad_pcb]
2024-10-11 ChairGuru V2.0.1
    11 OCT 24 Updates
    [G7 Senior Design V2-B_Cu.gbl, G7 Senior Design V2-B_Cu.gbr, G7 Senior Design V2-B_Mask.gbr, G7 Senior Design V2-B_Mask.gbs, G7 Senior Design V2-B_Paste.gbr, G7 Senior Design V2-B_Silkscreen.gbr, G7 Senior Design V2-Edge_Cuts.gbr, G7 Senior Design V2-F_Cu.gbr]
2024-10-12 handles x and y movement and then finishes with rotation, good stopping point until antenna integration is needed
2024-10-16 DRV8825 V1
    Custom PCB for Motor Drivers
    [DRV8825 V1.kicad_pcb, DRV8825 V1.kicad_sch, DRV8825PWPR.step]
2024-10-21 init motor code branch
2024-10-23 Added 4 motor code to drive forward
2024-10-23 motor code for 4 motors on v2.0.1 board headers
2024-10-23 working pin out and directory for 4 motor control
2024-10-24 testing library for soft-AP use case
2024-10-24 esp soft-ap working and logging simple http button request from x device to esp32 console
2024-10-24 Websocket is working and full-duplex between a third party device and esp communicate to server pc
2024-11-01 Triangulation Code update
    Update, all functional, missing 2nd tag code. Distance calculation afterward
    [Tag.ino, link.cpp]
2024-11-01 Test on Chassis
2024-11-04 Updated Motor Code. Everything is accurate except rotation.
2024-11-05 not working with motor code but esp hotspot is somwhat working, added api call on overview.js
    [AccessPointTesting.ino, MacAddressFinder.ino, TB6600_Code.ino]
2024-11-05 wireless netwroking from server now controls motors via access point
2024-11-06 updated motor code and addded buttons to frontend for testing
2024-11-08 updated some motor code and accidently some recon, switching branches
2024-11-09 motor code push
2024-11-10 Fixed if statements, added back translateLeft
    [TB6600_Code.ino]
2024-11-11 not working combo, mind schredded, come back another time
    [Combo.ino, TB6600_Code.cpp, TB6600_Code.h, TB6600_Code.ino, TagOG.cpp, TagOG.h, TagOG.ino, link.cpp]
2024-11-12 combo code working WITH MOTORS ONLY, but no compilation errors
    combo progress with motors, implementing tag and anchors to work together now, ALL PRIOR TO PATH PLANNING
    [AccessPointTesting.ino, Combo.ino, TB6600_Code.cpp, TB6600_Code.h, TB6600_Code.ino, TagOG.ino]
2024-11-12 motors working with cpp files and while including tag stuff, not integrated yet
2024-11-13 merging schematics to clear branches
    [Anchor Housing V1.stl, Anchor Housing V2 (3).stl, ChairBasePrototype.ipt]
2024-11-13 forgot stl's
2024-11-14 working tag coordinates with anchors and motor control via post commands - WORKING HERE
2024-11-14 motor commands working, tag info being read, erroring out on 404 server response for storing json tag data
    [Combo.ino, TagOG.h, link.cpp]
2024-11-14 working motor control with anchors reading pos, editing anchors going forward to save posistions, NOT tag
2024-11-14 FULL COMMUNICATION WORKING 🗣
2024-11-15 Updated Motor Code, functions now accept steps as arguments and do not convert to inches. For reference, 655 steps == 1 meter
2024-11-15 fixed ALECS mistake ( missing ")" added )
    [TB6600_Code.cpp]
2024-11-15 Slowed down RPM to hopefully increase torque/eliminate pulling left
2024-11-15 no errors in overview and testing recon
    [AccessPointTesting.ino, TB6600_Code.cpp]
2024-11-15 combo and combo2 addressable by ip, recon gives total path planning but at too large of a scale
    [Combo2.ino, TB6600_Code.cpp, TB6600_Code.h, TagOG.cpp, TagOG.h, link.cpp]
2024-11-19 untested overview visual updates and some motor code with estop to test
2024-11-19 revert motor code, visuals stuff looking ok
    [Combo.ino, TB6600_Code.cpp, TB6600_Code.h]
2024-11-19 visuals for landing page, overview, and automove look good, working here for everything functional
2024-11-25 Final CAD files added to GIT, ready to merge all branches to main and deploy package
    [Anchor Housing V1.stl, Anchor Housing V2 (3).stl, Bottom Joystick PCB.stl, BumperCustomPCB.ipt, BumperCustomPCB.stl, ChairBasePrototype.ipt, InventorSaveOfSTL.stl, InventorSaveOfV2STL.stl]
